hjsalman/3D-AGX-MODEL-/handles.stl

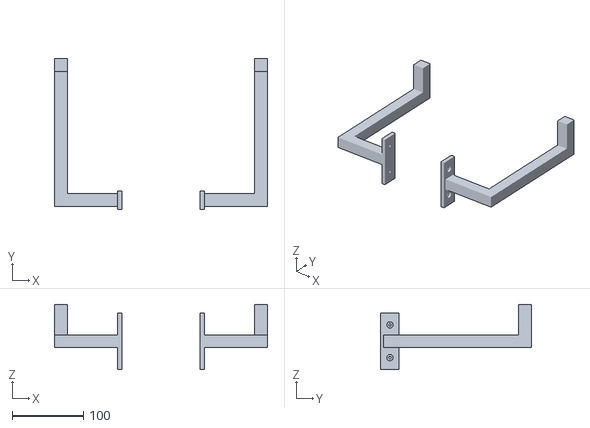
[picture p1: CAD file, 2026-07-13]
handles.stl
300.0 x 212.0 x 92.0
