hjsalman/3D-AGX-MODEL-/rig 3d print/right.stl

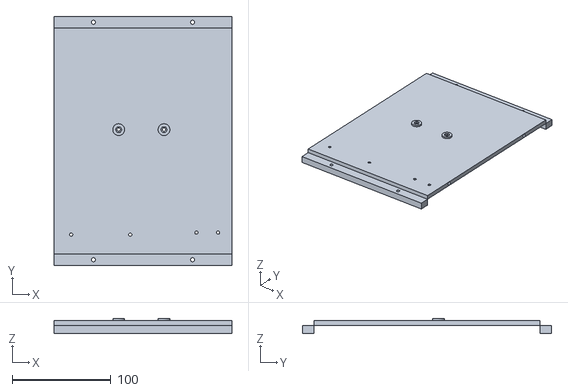
[picture p2: CAD file, 2026-07-17]
rig 3d print/right.stl
180.7 x 253.1 x 15.0
