hjsalman/3D-AGX-MODEL-/box_body.stl

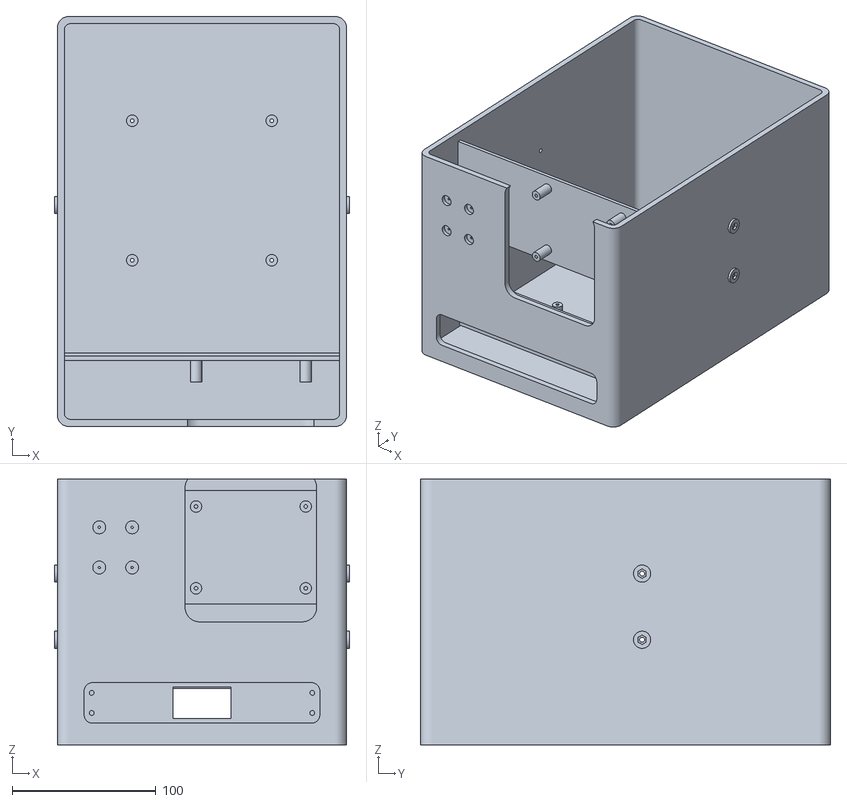
[picture p3: CAD file, 2026-07-13]
box_body.stl
205.2 x 285.1 x 184.7
