hjsalman/3D-AGX-MODEL-/rig 3d print/zed_plate.stl

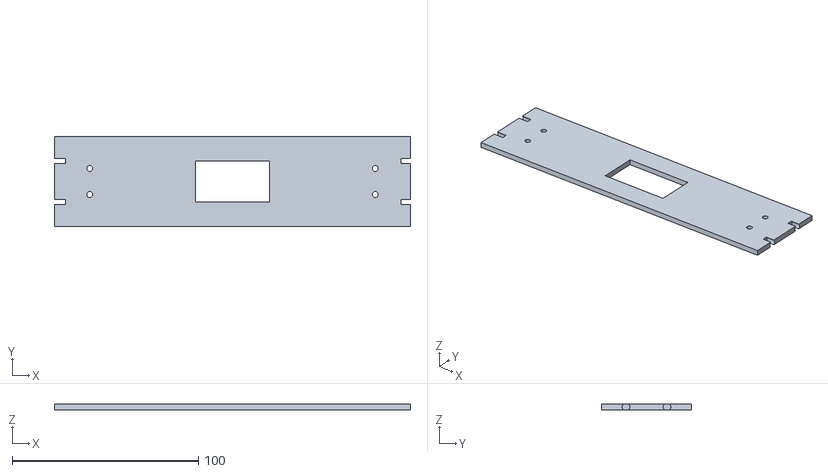
[picture p4: CAD file, 2026-07-17]
rig 3d print/zed_plate.stl
191.2 x 48.2 x 3.00
