hjsalman/3D-AGX-MODEL-/rig 3d print/rad_plate.stl

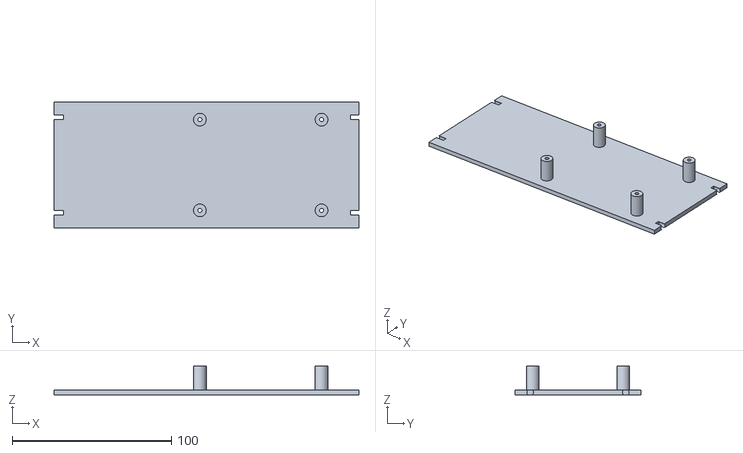
[picture p5: CAD file, 2026-07-17]
rig 3d print/rad_plate.stl
191.2 x 78.9 x 18.0
