hjsalman/3D-AGX-MODEL-/rig 3d print/floor.stl

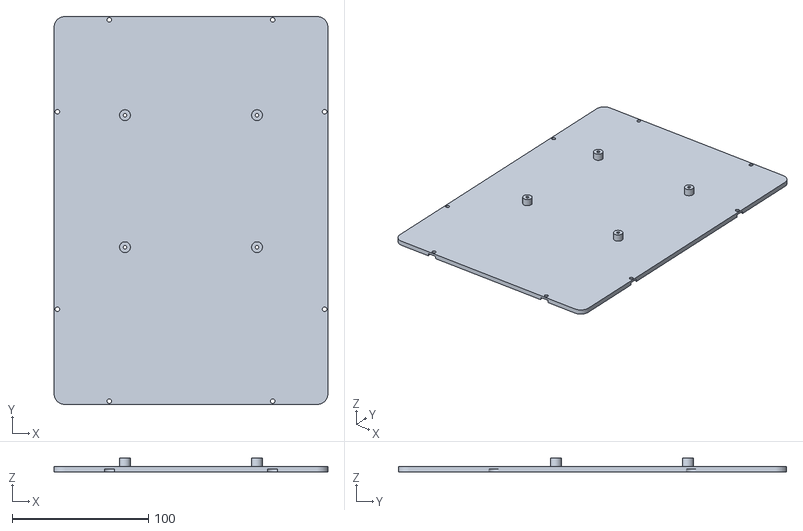
[picture p7: CAD file, 2026-07-17]
rig 3d print/floor.stl
201.2 x 285.1 x 10.0
