hjsalman/3D-AGX-MODEL-/rig 3d print/back.stl

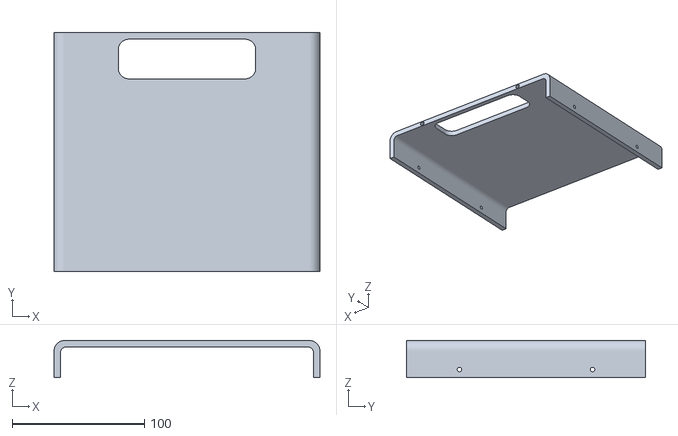
[picture p8: CAD file, 2026-07-17]
rig 3d print/back.stl
201.2 x 180.7 x 28.0
