hjsalman/3D-AGX-MODEL-/(list of files, cad)

Other CAD files:
rig 3d print/left.stl
rig 3d print/handles.stl
box_body.scad
handles.scad
rig 3d print/back.scad
rig 3d print/floor.scad
rig 3d print/front.scad
rig 3d print/handles.scad
rig 3d print/left.scad
rig 3d print/rad_plate.scad
rig 3d print/right.scad
rig 3d print/split_v39.scad
rig 3d print/zed_plate.scad
